cmonr/uBristleBot-PCB/board.png

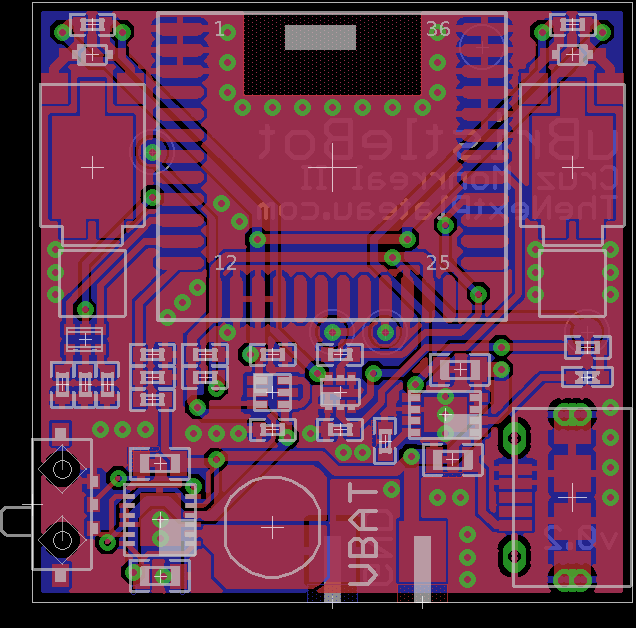
board.png
