cmonr/uBristleBot-PCB/schematic.png

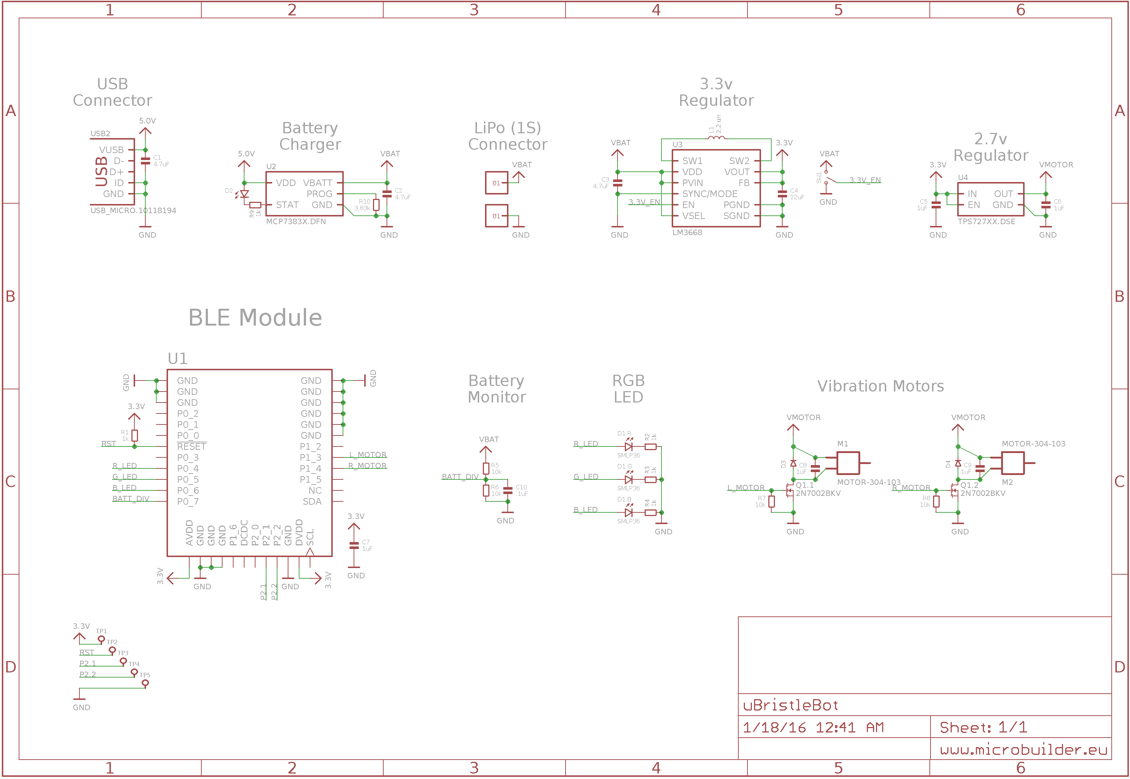
schematic.png
