cmonr/uBristleBot-PCB/uBristleBot.brd

## EAGLE design uBristleBot.brd (2016-01-18)

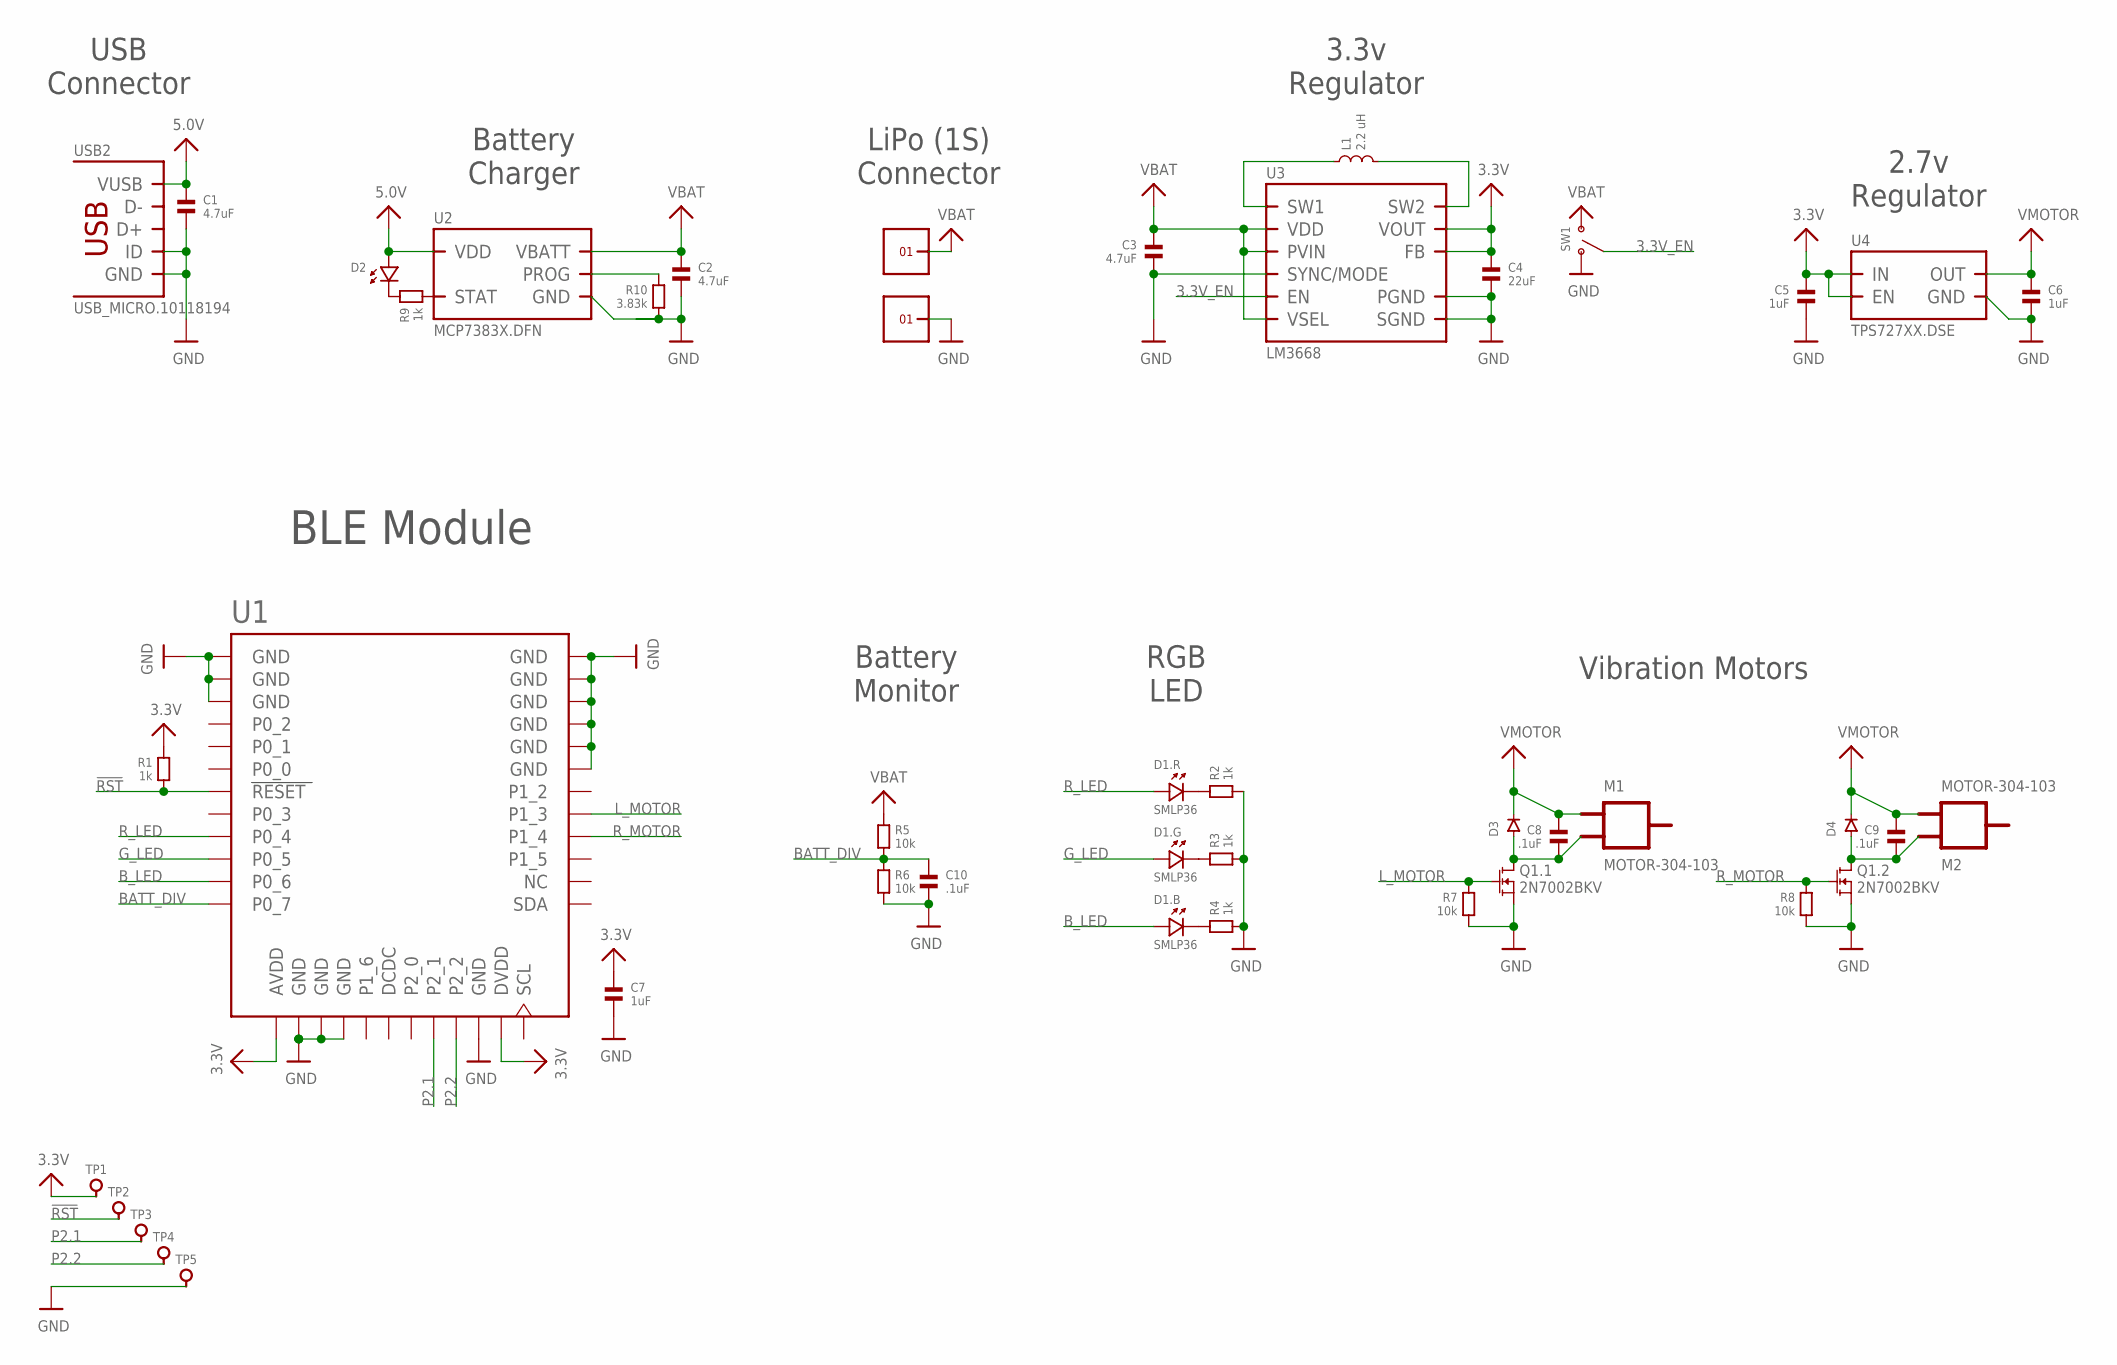
[picture p3: schematic uBristleBot.sch]

Parts:
C1, C2, C3: 4.7uF; 0603
C4: 22uF; 0603
C5, C6, C7: 1uF; 0402
C8, C9, C10: .1uF; 0402
D1: SMLP36; 0604
D2: LED.0402; 0402.LED
D3, D4: DIODE.SOD-523F; SOD-523F
L1: 2.2 uH; SDR0403
M1, M2: MOTOR-304-103; 304-103
Q1: 2N7002BKV; SOT666
R1, R2, R3, R4, R9: 1k; 0402
R5, R6, R7, R8: 10k; 0402
R10: 3.83k; 0402
SW1: SSAJ110100
TP1, TP2, TP3, TP4, TP5: PCB_PAD.42MIL; 0906-0_PAD
U1: BLE121LR-VISUAL-A; BLE121LR-A
U2: MCP7383X.DFN; DFN8-3X2.PAD
U3: LM3668; LLP.12.3X3MM
U4: TPS727XX.DSE; DSE
U$31, U$34: 1X1
USB2: USB_MICRO.10118194; 10118194

Connections:
3.3V: C4.1, C5.1, C7.1, R1.1, TP1.PAD, U1.AVDD, U1.DVDD, U3.1 (VOUT), U3.12 (FB), U4.4 (EN), U4.6 (IN)
3.3V_EN: SW1.C (COM), U3.6 (EN)
5.0V: C1.1, D2.P$1 (1), U2.1 (VDD), U2.2 (VDD), USB2.1 (VUSB)
!RST: R1.2, TP2.PAD, U1.RESET
BATT_DIV: C10.1, R5.2, R6.1, U1.P0_7
B_LED: D1.1 (+), U1.P0_6
GND: C1.2, C2.2, C3.2, C4.2, C5.2, C6.2, C7.2, C10.2, Q1.1 (S), Q1.4 (S), R2.2, R3.2, R4.2, R6.2, R7.2, R8.2, R10.2, SW1.1 (A), TP5.PAD, U1.GND, U1.GND@2 (GND), U1.GND@3 (GND), U1.GND@4 (GND), U1.GND@5 (GND), U1.GND@6 (GND), U1.GND@7 (GND), U1.GND@8 (GND), U1.GND@9 (GND), U1.GND@10 (GND), U1.GND@11 (GND), U1.GND@12 (GND), U1.GND@13 (GND), U2.6 (GND), U2.PAD (GND), U3.3 (PGND), U3.8 (SGND), U3.9 (SGND), U3.10 (SYNC/MODE), U3.PAD (SGND), U4.3 (GND), U$34.1, USB2.4 (ID), USB2.5 (GND), USB2.PAD@1 (GND), USB2.PAD@2 (GND), USB2.PAD@3 (GND), USB2.PAD@4 (GND), USB2.PAD@5 (GND), USB2.PAD@6 (GND), USB2.PAD@7 (GND), USB2.PAD@8 (GND), USB2.PAD@9 (GND), USB2.PAD@10 (GND), USB2.PAD@11 (GND), USB2.PAD@12 (GND), USB2.PAD@13 (GND), USB2.PAD@14 (GND), USB2.PAD@15 (GND), USB2.PAD@16 (GND)
G_LED: D1.3 (+), U1.P0_5
L_MOTOR: Q1.2 (G), R7.1, U1.P1_3
unnamed: D1.5 (-), R2.1
unnamed: D1.4 (-), R3.1
unnamed: D1.6 (-), R4.1
unnamed: L1.1, U3.4 (SW1)
unnamed: C8.2, D3.A, M1.2, Q1.6 (D)
unnamed: C9.2, D4.A, M2.1, Q1.3 (D)
unnamed: R9.2, U2.5 (STAT)
unnamed: D2.P$2 (2), R9.1
unnamed: R10.1, U2.8 (PROG)
unnamed: L1.2, U3.2 (SW2)
P2.1: TP3.PAD, U1.P2_1
P2.2: TP4.PAD, U1.P2_2
R_LED: D1.2 (+), U1.P0_4
R_MOTOR: Q1.5 (G), R8.1, U1.P1_4
VBAT: C2.1, C3.1, R5.1, SW1.2 (B), U2.3 (VBATT), U2.4 (VBATT), U3.5 (PVIN), U3.7 (VDD), U3.11 (VSEL), U$31.1
VMOTOR: C6.1, C8.1, C9.1, D3.C, D4.C, M1.1, M2.2, U4.1 (OUT)

Notes on the sheet:
USB Connector
LiPo (1S) Connector
Battery Charger
3.3v Regulator
2.7v Regulator
BLE Module
Battery Monitor
RGB LED
Vibration Motors

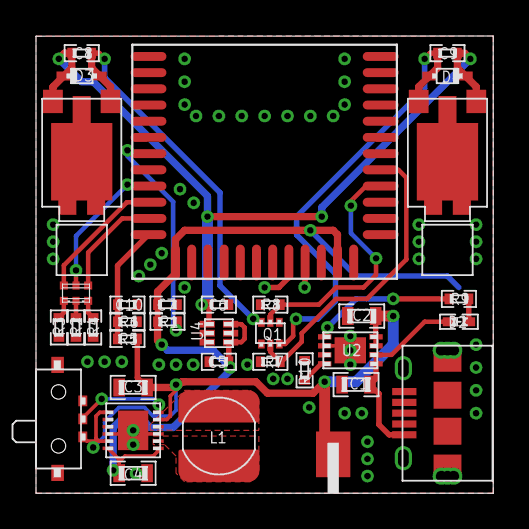
[picture p4: board uBristleBot.brd from above]

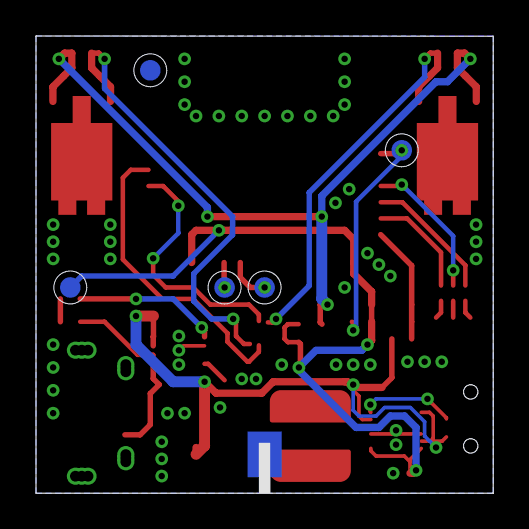
[picture p5: board uBristleBot.brd from below]

Board: 2 copper layers, 25.4 x 25.4 mm, 41 parts (6 on the bottom side), 25 nets.
