cmonr/uBristleBot-PCB/(threads)

Thread 1 (2016-01-06):

Move RGB PWM pins

cmonr, 2016-01-06:
Pin 0.2 conflicts with Right Motor PWM pin (Timer Channels).

Move Pins from P0.3-5 to P0.4-6

Closed 2016-01-18.

Thread 2 (2016-01-06):

Fix charging LED Soldermask

cmonr, 2016-01-06:
Soldermask is currently on bStop, not tStop.

Also, check and correct all other footprints in library.

Closed 2016-01-18.

Thread 4 (2016-01-06):

Move location of battery connector

cmonr, 2016-01-06:
Move battery connector vias to edge of PCB to make soldering a bit easier, and lower the risk of shorting.

Closed 2016-01-18.

Thread 7 (2016-01-07):

Move RGB LED to edge of board

cmonr, 2016-01-07:
The battery "mounts" to the top of the PCB via double sided tape. It would be nice/useful if the LED was still visible.

Closed 2016-01-18.

Thread 8 (2016-01-17):

Replace Programming Vias with SMD Pads

cmonr, 2016-01-17:
Use 0906-0-15-20-76-14-11-0 from Mill Max
Reference: https://www.mill-max.com/assets/pdfs/023-028.pdf

Closed 2016-01-18.

Thread 9 (2016-01-17):

Create Programming PCB

cmonr, 2016-01-17:
Reference: 0906-0-15-20-76-14-11-0 (MillMax)

cmonr, 2016-01-19:
https://github.com/cmonr/uBristleBot-PCB-PogoProgrammer/releases/tag/v0.1

Closed 2016-01-19.
