cmonr/uBristleBot-PCB/(commit log)

2015-11-20 Initial Commit. Schematic ready for review
    [uBristleBot.brd, uBristleBot.sch]
2015-11-21 Component placement mostly complete. Beginning layout
    [uBristleBot.brd, uBristleBot.sch]
2015-11-21 Layout complete and ready for review
    [uBristleBot.brd, uBristleBot.sch]
2016-01-17 Updated Inuctor and LED layer parts, and moved PWM pins. Ripped up programming connector in prep for Pogo Pins
    [uBristleBot.brd, uBristleBot.sch]
2016-01-18 Finished layout of v0.2
    [uBristleBot.brd, uBristleBot.sch]
2016-01-18 Tweaked layout for GND plane
    [uBristleBot.brd]
2018-10-01 Added csv BoM. Not sure how that was missed...
    [uBristleBot.csv]
2018-10-01 Corrected exported csv to _actually_ use commas. FFS Eagle...
    [uBristleBot.csv]
